jagmevada/show-timer/cad/holder_with clips.jpeg

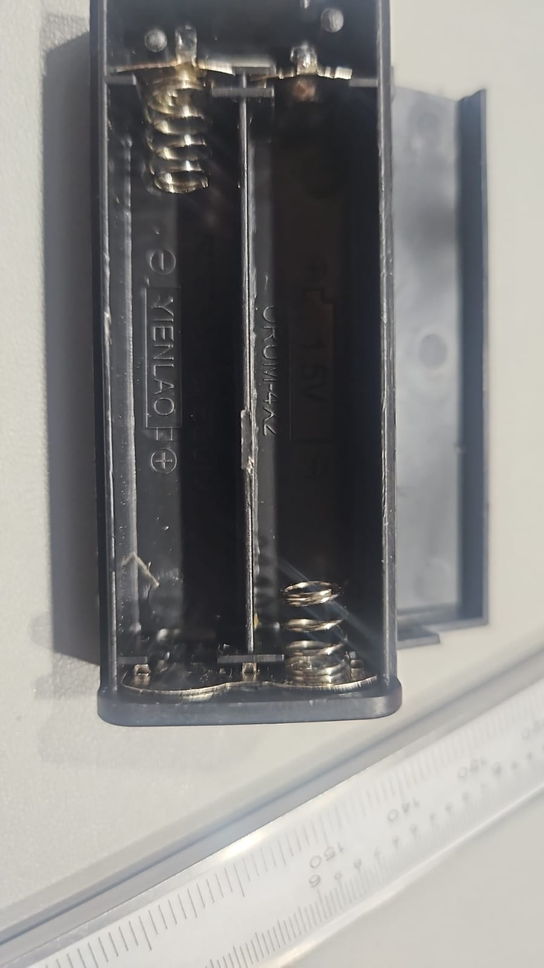
cad/holder_with clips.jpeg
