jagmevada/show-timer/cad/holder_without_clips.jpeg

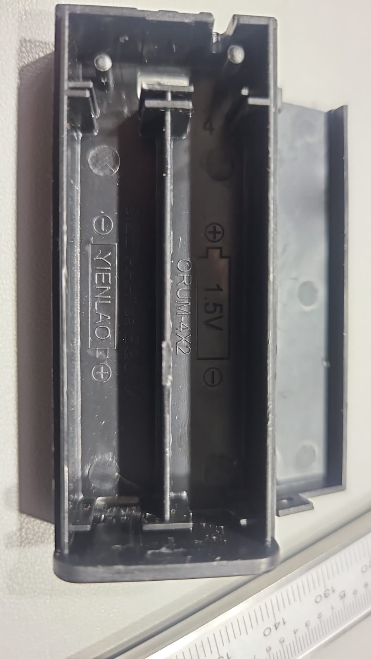
cad/holder_without_clips.jpeg
