jagmevada/show-timer/work/old_board_geom.md

# remote_1 (built board) geometry, read 2026-10-11 from JLCONE PCB 52caa9452ee66dee (mil, layer 1 = top, 2 = bottom)
Outline: x 1.2…1418.5, y −59.4…2952.4 (36.0 × 76.5 mm). Corners: large concave/convex arc steps (see polys below).
Polylines (layer 11):
L 119.29,2686.61→79.92,2686.61 | L 266.93,2873.62→266.93,2834.25 | L 1152.76,2834.25→1152.76,2873.62 | L 1339.76,2686.61→1300.39,2686.61
L 1300.39,206.30→1339.76,206.30 | L 1152.76,19.29→1152.76,58.66 | L 266.93,58.66→266.93,19.29 | L 79.92,206.30→119.29,206.30
L 1418.50,285.04→1418.50,2607.87 | L 345.67,−59.45→1074.02,−59.45 | L 1.18,2607.87→1.18,285.04 | L 1074.02,2952.36→345.67,2952.36
ARC90 79.92,2686.61→1.18,2607.87 | ARC90 119.29,2686.61→266.93,2834.25 | ARC90 345.67,2952.36→266.93,2873.62 | ARC90 1152.76,2873.62→1074.02,2952.36
ARC90 1152.76,2834.25→1300.39,2686.61 | ARC90 1418.50,2607.87→1339.76,2686.61 | ARC90 1339.76,206.30→1418.50,285.04 | ARC90 1300.39,206.30→1152.76,58.66
ARC90 1074.02,−59.45→1152.76,19.29 | ARC90 266.93,19.29→345.67,−59.45 | ARC90 266.93,58.66→119.29,206.30 | ARC90 1.18,285.04→79.92,206.30

Keep positions (top): S1 power 276.8,1141.3 | S2 709.8,1141.3 | S3 276.8,708.3 | S4 709.8,708.3 | S5 1142.9,708.3 | S6 709.8,275.2 (all rot 0)
  (S1 = power on PA6 net "S6"; nav S2..S6 → nets S1..S5 in old schematic)
JP1 OLED header top 709.8,2576.4 rot 180 | JP4 batt top 1279.5,2405.5 rot 90 | JP2 batt bottom 141.7,2405.5 rot 90
JP3 UPDI top 1333.4,1427.7 rot −90 | JP5 UART bottom 1330.1,1804.5 rot 90 | A1 HC-12 bottom 709.8,983.9 rot 0
JP6/JP7 (VBAT→VBAT_O jumpers) bottom 142.5,2163.4 / 1278,2163.4
U1 MCU bottom 913.8,1558.2 rot 270 | U2 DC-DC bottom 309.4,1684.6 | L1 bottom 304.7,1459.1
