jagmevada/show-timer/cad/clips.jpeg

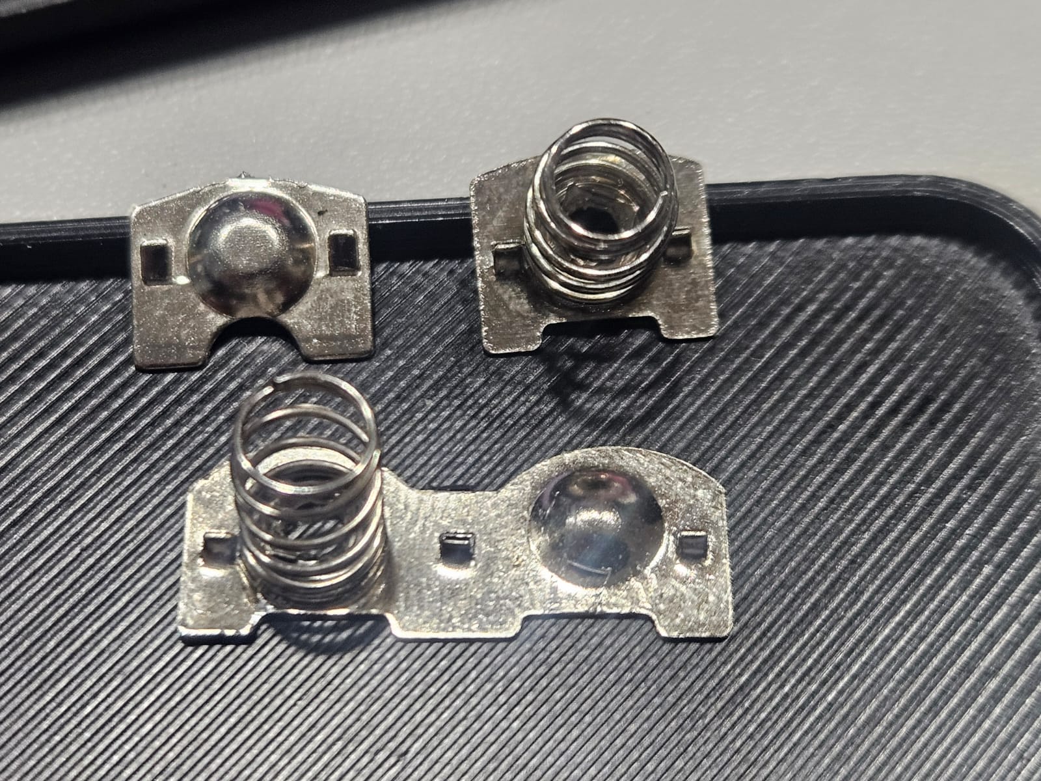
cad/clips.jpeg
