jagmevada/show-timer/cad/plate_zoome.jpeg

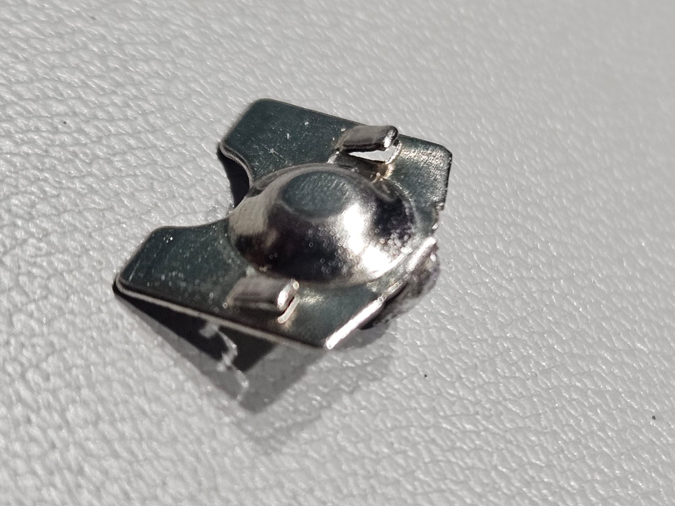
cad/plate_zoome.jpeg
