jagmevada/show-timer/cad/series_clip_zoom_image.jpeg

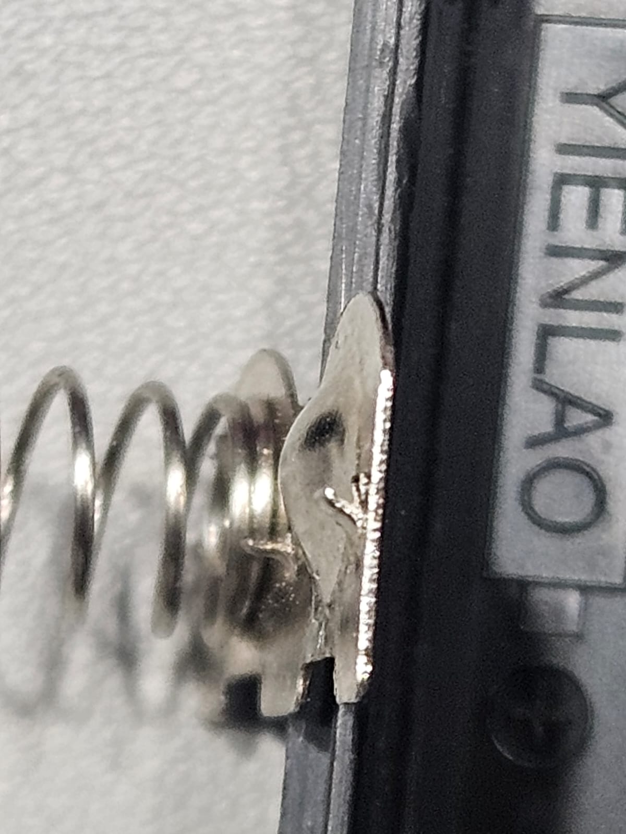
cad/series_clip_zoom_image.jpeg
