jagmevada/show-timer/cad/spring_zoom.jpeg

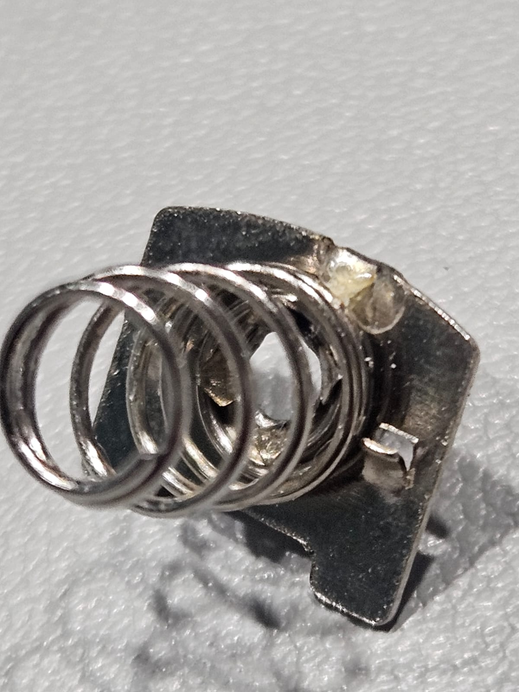
cad/spring_zoom.jpeg
