jagmevada/show-timer/docs/datasheets/TS-1187A_drawing.jpg

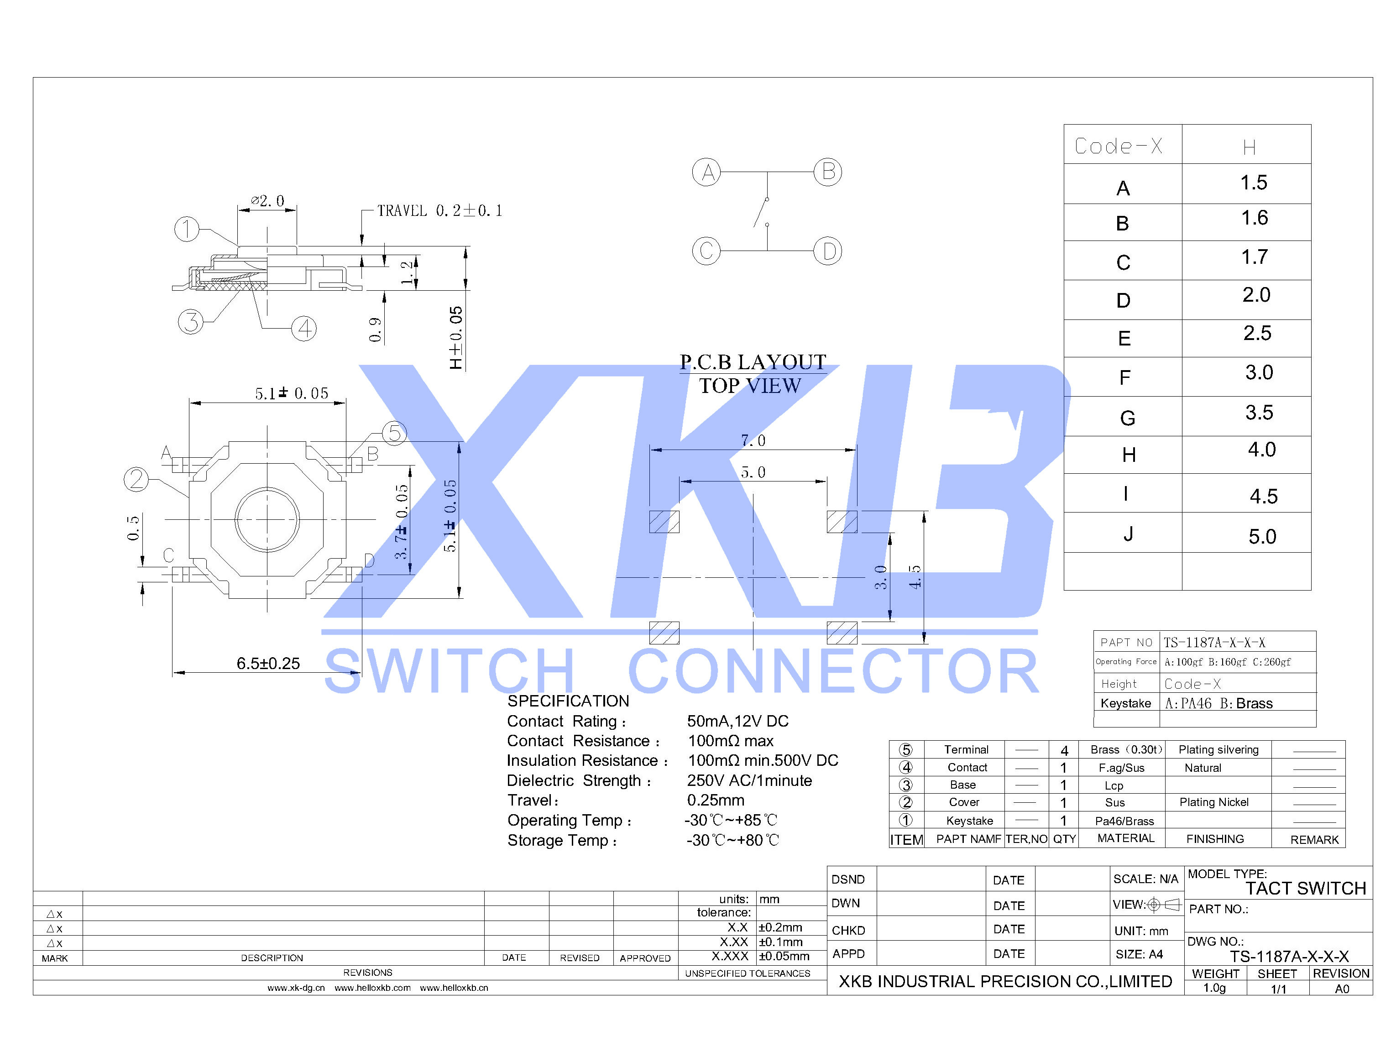
docs/datasheets/TS-1187A_drawing.jpg
