jagmevada/show-timer/docs/images/silk_bottom_gerber_topview.png

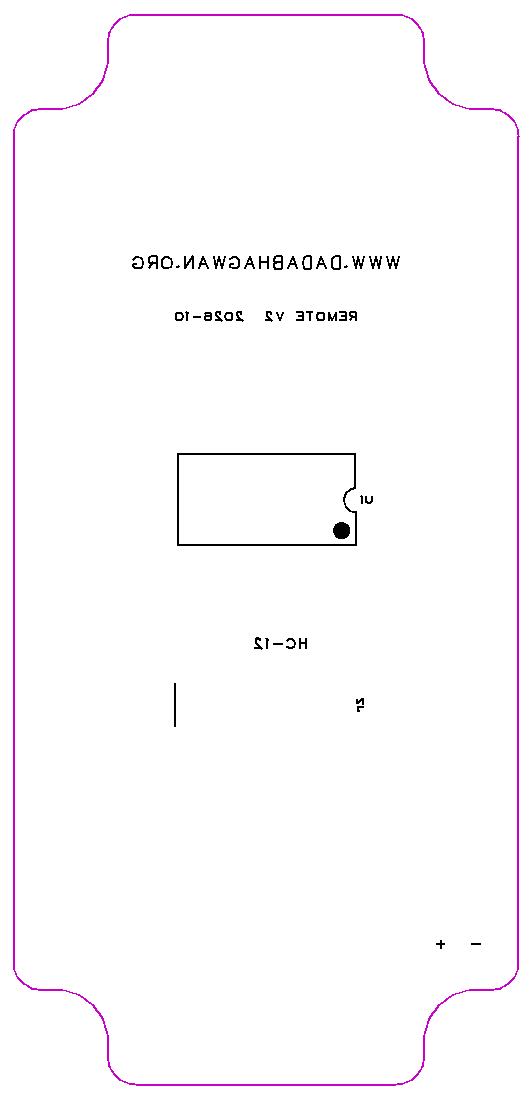
docs/images/silk_bottom_gerber_topview.png
