jagmevada/show-timer/docs/images/silk_top_gerber.png

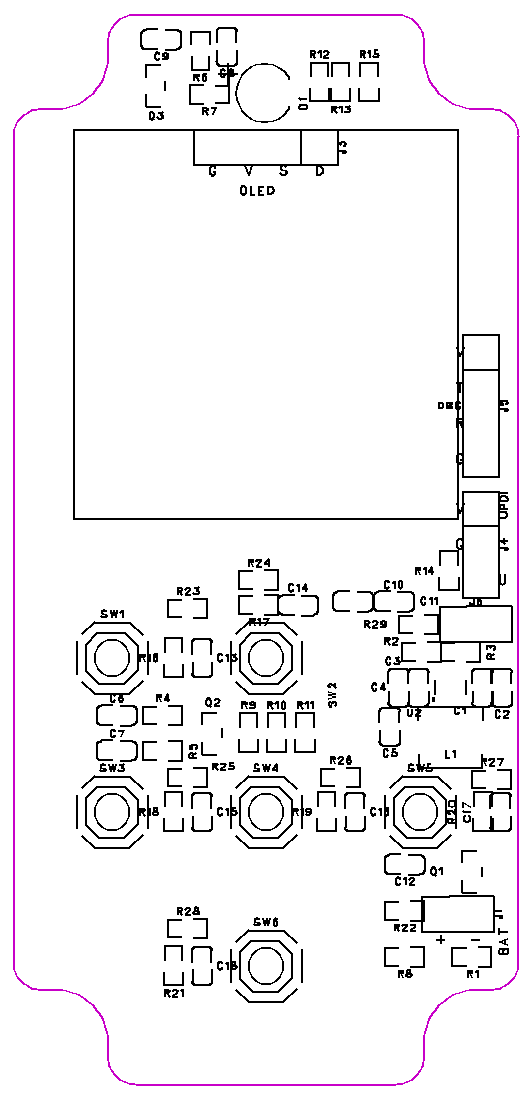
docs/images/silk_top_gerber.png
