jagmevada/show-timer/release/remote_v2_2026-10-11_BOM.csv

Supplier | Supplier Part | Manufacturer | Manufacturer Part | Value | Footprint | Designator | Comment | Quantity | No.
LCSC | C19702 | SAMSUNG(三星) | CL10A106KP8NNNC | 10uF | C0603 | C1,C9 | 10uF | 2 | 1
LCSC | C14663 | YAGEO(国巨) | CC0603KRX7R9BB104 | 100nF | C0603 | C2,C5,C10,C12,C13,C14,C15,C16,C17,C18 | 100nF | 10 | 2
LCSC | C59461 | SAMSUNG(三星) | CL10A226MQ8NRNC | 22uF | C0603 | C3,C4,C7,C11 | 22uF | 4 | 3
LCSC | C1622 | SAMSUNG(三星) | CL10B473KB8NNNC | 47nF | C0603 | C6,C8 | 47nF | 2 | 4
LCSC | C167203 | cjiang(长江微电) | FXL0420-1R0-M | 1uH | IND-SMD_L4.4-W4.2 | L1 | 1uH | 1 | 5
LCSC | C15127 | AOS | AO3401A |  | SOT-23_L2.9-W1.3-P1.90-LS2.4-BR | Q1,Q2,Q3 | AO3401A | 3 | 6
LCSC | C25803 | UNI-ROYAL(厚声) | 0603WAF1003T5E | 100kΩ | R0603 | R1,R4,R6 | 100kΩ | 3 | 7
LCSC | C23178 | UNI-ROYAL(厚声) | 0603WAF4703T5E | 470kΩ | R0603 | R2 | 470kΩ | 1 | 8
LCSC | C23254 | UNI-ROYAL(厚声) | 0603WAF8202T5E | 82kΩ | R0603 | R3 | 82kΩ | 1 | 9
LCSC | C25804 | UNI-ROYAL(厚声) | 0603WAF1002T5E | 10kΩ | R0603 | R5,R7,R23,R24,R25,R26,R27,R28 | 10kΩ | 8 | 10
LCSC | C23137 | UNI-ROYAL(厚声) | 0603WAF3303T5E | 330kΩ | R0603 | R8 | 330kΩ | 1 | 11
LCSC | C21190 | UNI-ROYAL(厚声) | 0603WAF1001T5E | 1kΩ | R0603 | R9,R10,R11,R15,R16,R17,R18,R19,R20,R21 | 1kΩ | 10 | 12
LCSC | C23162 | UNI-ROYAL(厚声) | 0603WAF4701T5E | 4.7kΩ | R0603 | R12,R13 | 4.7kΩ | 2 | 13
LCSC | C23179 | UNI-ROYAL(厚声) | 0603WAF4700T5E | 470Ω | R0603 | R14 | 470Ω | 1 | 14
LCSC | C22935 | UNI-ROYAL(厚声) | 0603WAF1004T5E | 1MΩ | R0603 | R22 | 1MΩ | 1 | 15
LCSC | C23192 | UNI-ROYAL(厚声) | 0603WAF5103T5E | 510kΩ | R0603 | R29 | 510kΩ | 1 | 16
LCSC | C318884 | XKB Connection(中国星坤) | TS-1187A-B-A-B |  | SW-SMD_4P-L5.1-W5.1-P3.70-LS6.5-TL_H1.5 | SW1,SW2,SW3,SW4,SW5,SW6 | TS-1187A-B-A-B | 6 | 17
LCSC | C5219190 | TI(德州仪器) | TPS631000DRLR |  | SOT-583-8_L2.1-W1.2-P0.50-LS1.6-BL | U2 | TPS631000DRLR | 1 | 18
