jagmevada/show-timer/cad/Top Cover Flex Buttons.STEP

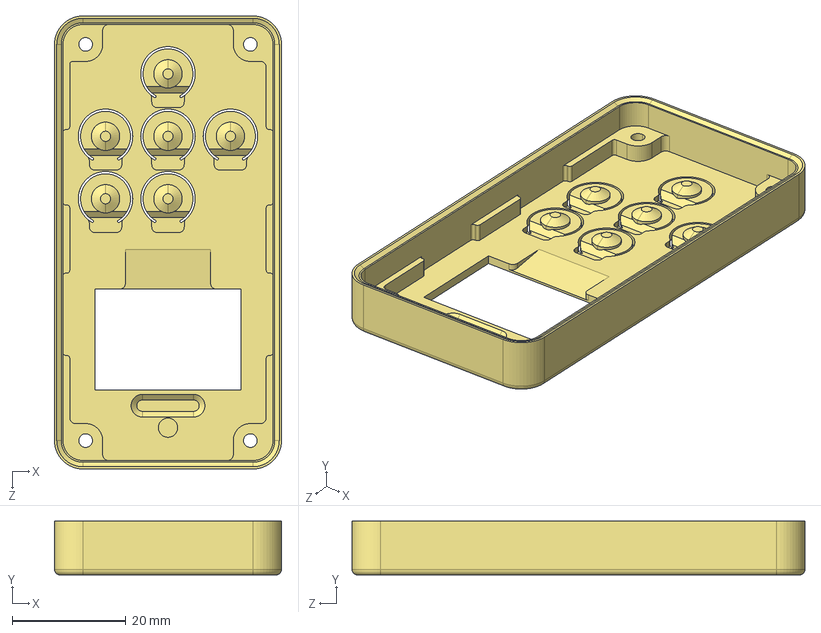
[picture p11: CAD file, 2026-11-08]
cad/Top Cover Flex Buttons.STEP
40.0 x 9.50 x 79.8 mm
