jagmevada/show-timer/cad/Battery Door 2xAAA.stp

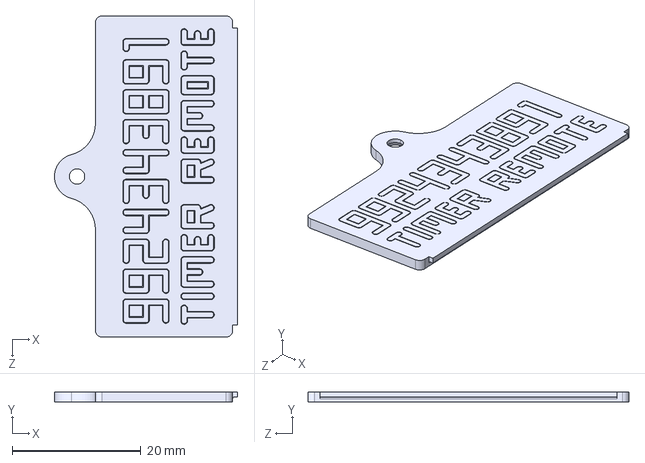
[picture p12: CAD file, 2026-11-08]
cad/Battery Door 2xAAA.stp
28.4 x 1.60 x 49.8 mm
