jagmevada/show-timer/cad/Bottom Cover 2xAAA Split.stp

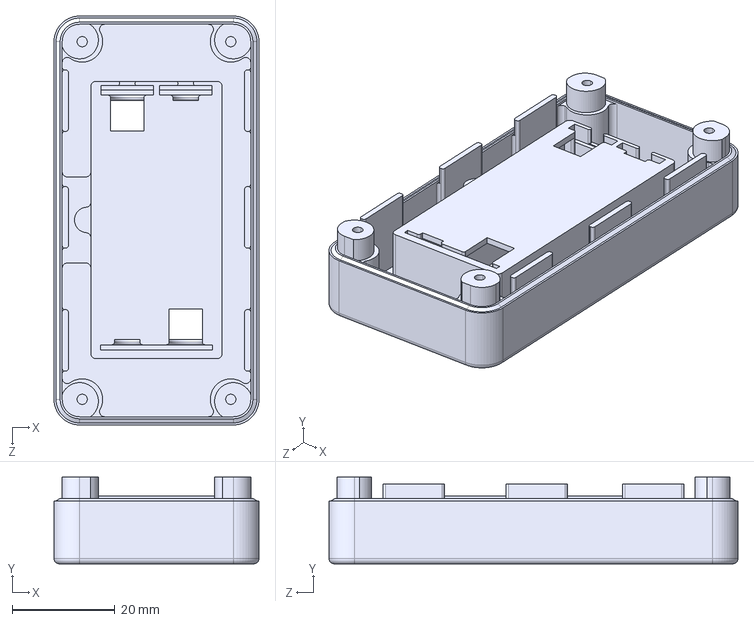
[picture p13: CAD file, 2026-11-08]
cad/Bottom Cover 2xAAA Split.stp
40.0 x 16.9 x 79.8 mm
