jagmevada/show-timer/cad/Clip Plus 10 (dimple).SLDPRT

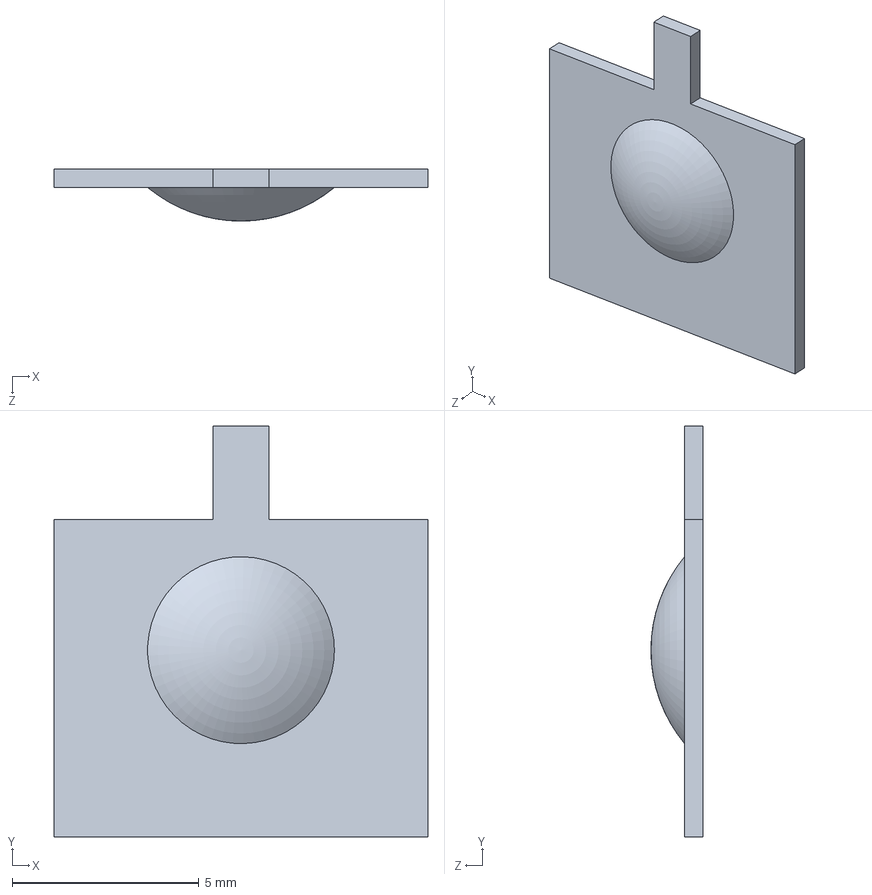
[picture p14: CAD file, 2026-11-07]
cad/Clip Plus 10 (dimple).SLDPRT
10.0 x 11.0 x 1.40 mm
