jagmevada/show-timer/cad/Clip Minus 10 (spring).SLDPRT

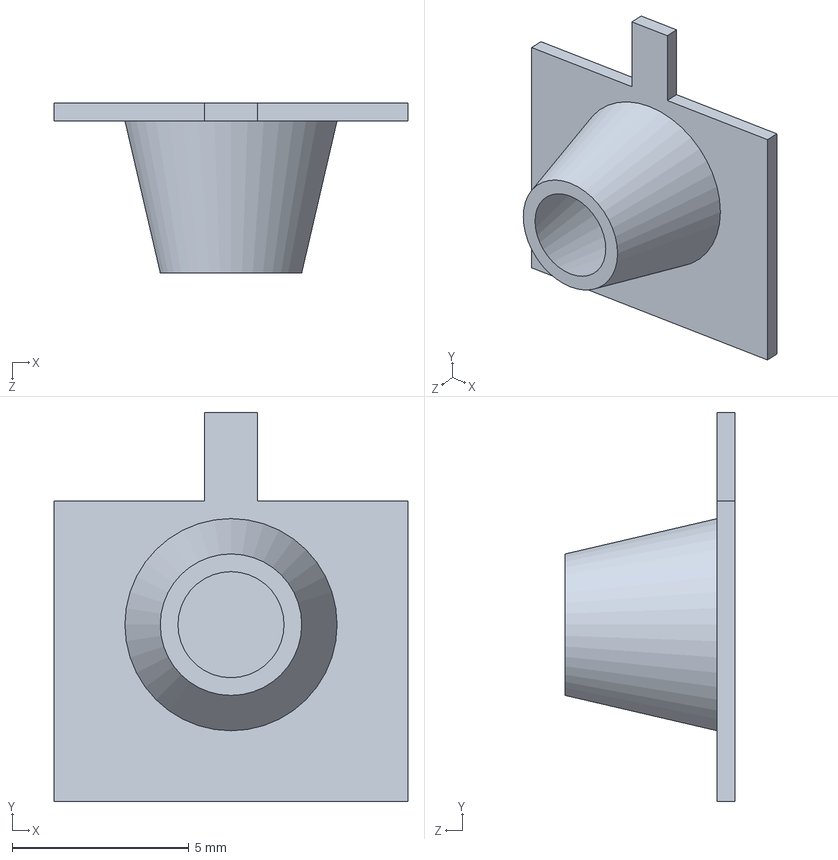
[picture p15: CAD file, 2026-11-07]
cad/Clip Minus 10 (spring).SLDPRT
10.0 x 11.0 x 4.80 mm
