jagmevada/show-timer/cad/Clip Series 21.6 (spring + dimple).SLDPRT

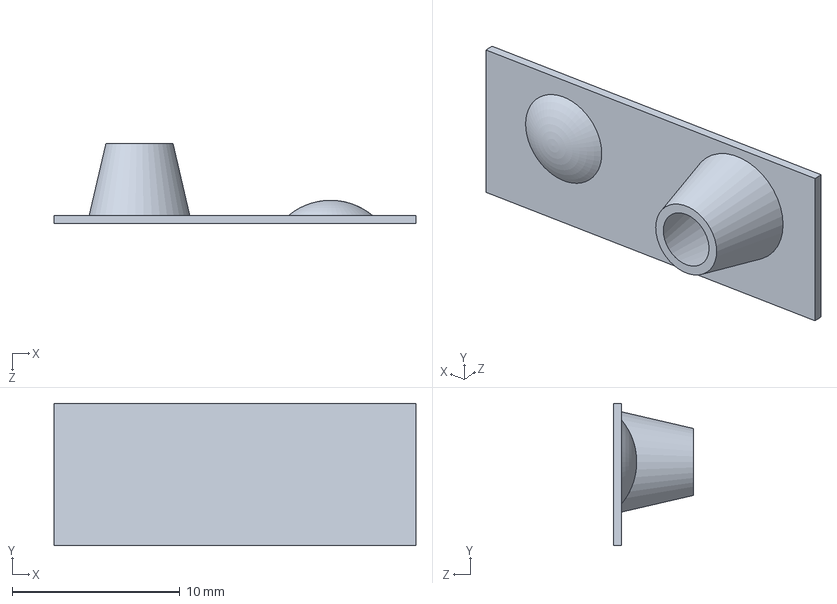
[picture p16: CAD file, 2026-11-07]
cad/Clip Series 21.6 (spring + dimple).SLDPRT
21.6 x 8.50 x 4.80 mm
