jagmevada/show-timer/cad/Bottom Cover 2xAAA.stp

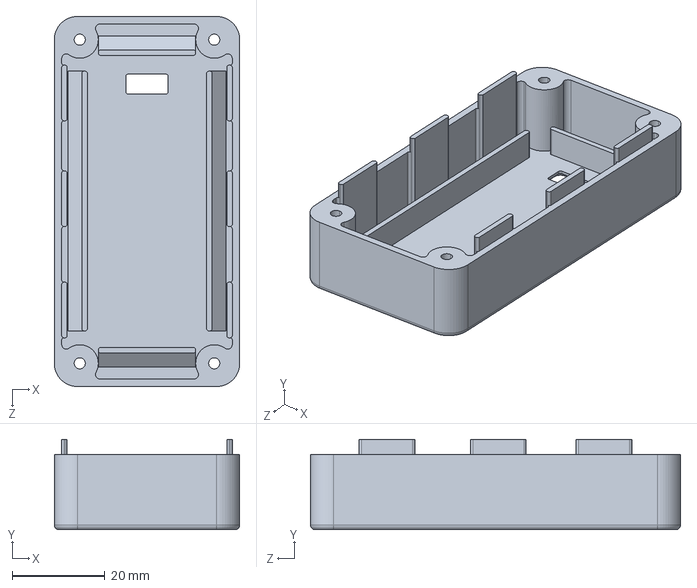
[picture p17: CAD file, 2026-11-07]
cad/Bottom Cover 2xAAA.stp
40.0 x 19.5 x 79.8 mm
