jagmevada/show-timer/cad/2xAAA Holder.SLDPRT

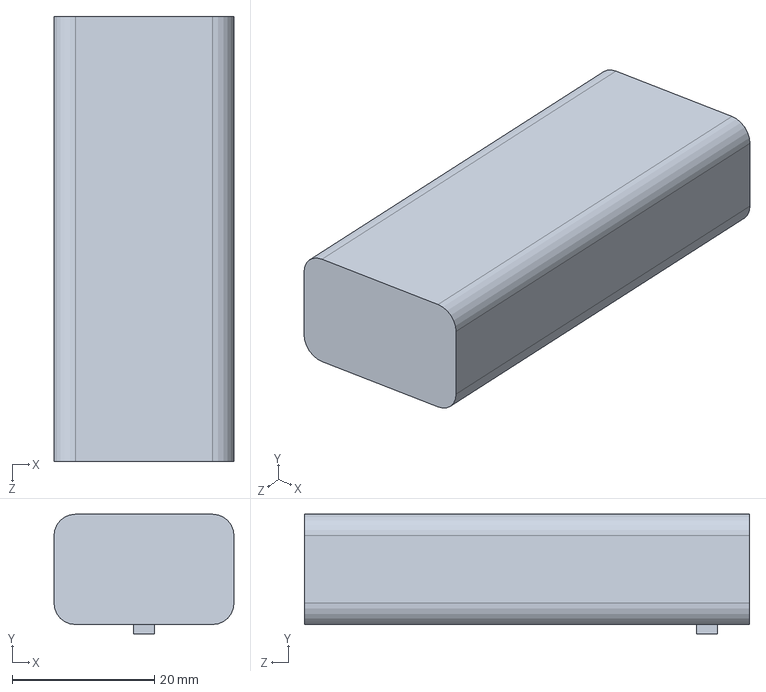
[picture p18: CAD file, 2026-11-07]
cad/2xAAA Holder.SLDPRT
25.3 x 16.8 x 62.6 mm
