jagmevada/show-timer/cad/remote_v2_easyeda.step

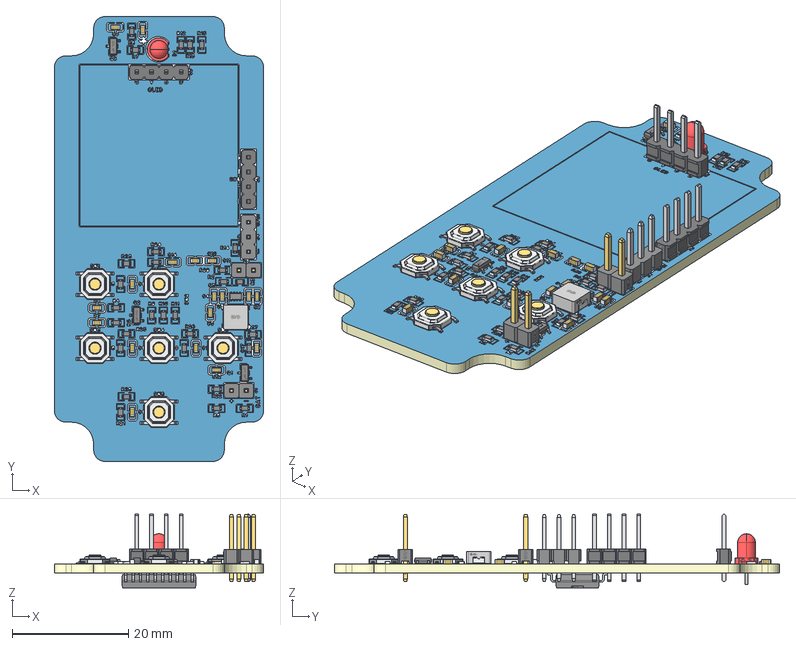
[picture p19: CAD file, 2026-11-07]
cad/remote_v2_easyeda.step
36.0 x 76.5 x 12.6 mm
Board~RLxt
TopCopper~RLxt
BottomCopper~RLxt
TopSilkscreen~RLxt x 264
BottomSilkscreen~RLxt x 47
TopFpcStiffener~RLxt
BottomFpcStiffener~RLxt
C0603~C0603_L1.6-W0.8-H0.8~PFH3 x 18
SOT-23_L2.9-W1.3-P1.90-LS2.4-BR~SOT-23-3P_L2.9-W1.3-H1.0-LS2.4-P0.95~D9QO x 3
HDR-TH_4P-P2.54-V-M~HDR-TH_4P-P2.54-M-LI-1X4P~CmQn x 2
R0603~R0603~sLe5 x 29
IND-SMD_L4.4-W4.2~IND-SMD_L4.2-W4.4-H2.0~V463
HDR-TH_3P-P2.54-V-M_PZ254V-11-03P~HDR-TH_3P-P2.54-V-M_PZ254V-11-03P~YAWt
HDR-TH_2P-P2.54-V-M~HDR2.54-M-LI-1X2P~ll9v x 2
SOT-583-8_L2.1-W1.2-P0.50-LS1.6-BL~SOT-583-8_L2.1-W1.2-P0.50-LS1.6-BL~nwCS
SW-SMD_4P-L5.1-W5.1-P3.70-LS6.5-TL_H1.5~SW-SMD_4P-L5.1-W5.1-P3.70-LS6.5-TL_H1.5~J6qV x 6
SOIC-20_L12.8-W7.5-P1.27-LS10.3-BL~SOIC-20_L12.8-W7.5-P1.27-LS10.3-BL~DwzO
LED-TH_BD3.8-P2.54-FD~LED-TH_BD3.8-P2.54-FD~qmMz
