jagmevada/show-timer/cad/HC-12_module.step

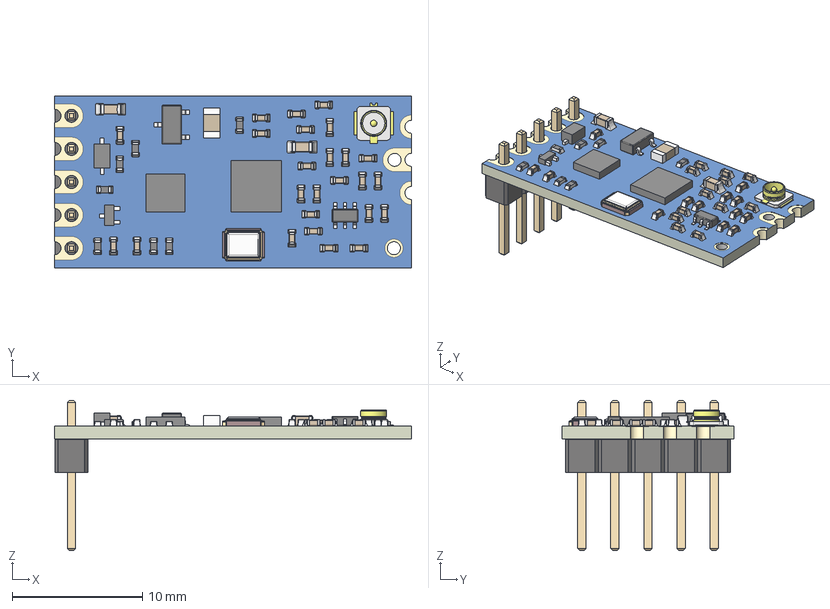
[picture p20: CAD file, 2026-11-07]
cad/HC-12_module.step
27.4 x 13.2 x 11.5 mm
SOP-3
TSOP-6 2mm
resistor_0402 x 7
cap0603_03 x 2
cap0402 x 25
HC12-PCB
PinHeader_1x05_P254mm_Vertical
