jagmevada/show-timer/cad/Remote Assembly v3.SLDASM

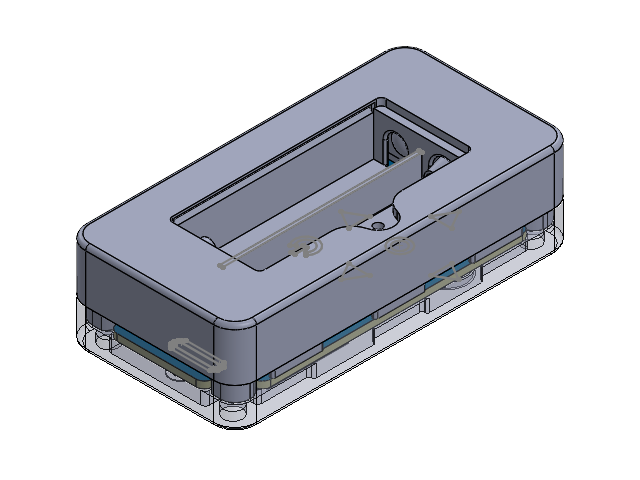
[picture p21: CAD file, 2026-11-09]
cad/Remote Assembly v3.SLDASM
Top Cover Flex Buttons
remote_v2_assembly
Bottom Cover 2xAAA Split
Clip Series 21.6 (spring + dimple)
Clip Plus 10 (dimple)
Clip Minus 10 (spring)
