jagmevada/show-timer/cad/Remote Assembly v2.SLDASM

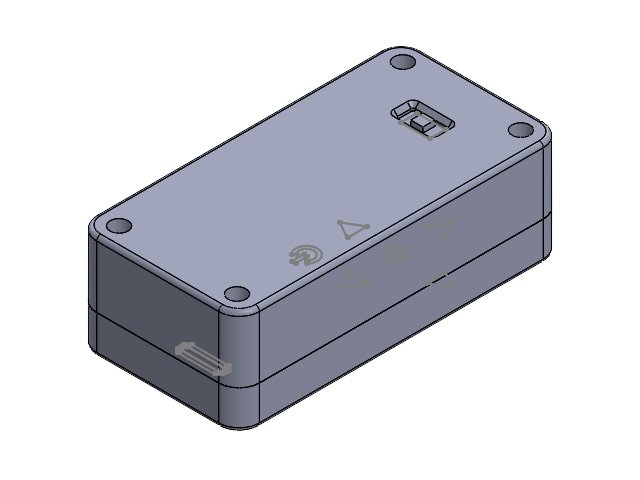
[picture p22: CAD file, 2026-11-09, an earlier design]
cad/Remote Assembly v2.SLDASM
Top Cover Flex Buttons
remote_v2_assembly
Bottom Cover 2xAAA
2xAAA Holder
