jagmevada/show-timer/(list of files, cad)

Other CAD files:
cad/Battery Door 2xAAA.SLDPRT
cad/Bottom Cover 2xAAA Split.SLDPRT
cad/Bottom Cover 2xAAA.SLDPRT
cad/Top Cover Flex Buttons.SLDPRT
cad/Top Cover Flex Buttons.stp
cad/remote_v2_assembly.SLDASM
cad/remote_v2_assembly.SLDPRT
