jagmevada/show-timer/docs/old_remote/src/github_dcdc/combined.brd

## EAGLE design docs/old_remote/src/github_dcdc/combined.brd (2026-11-02, an earlier design)

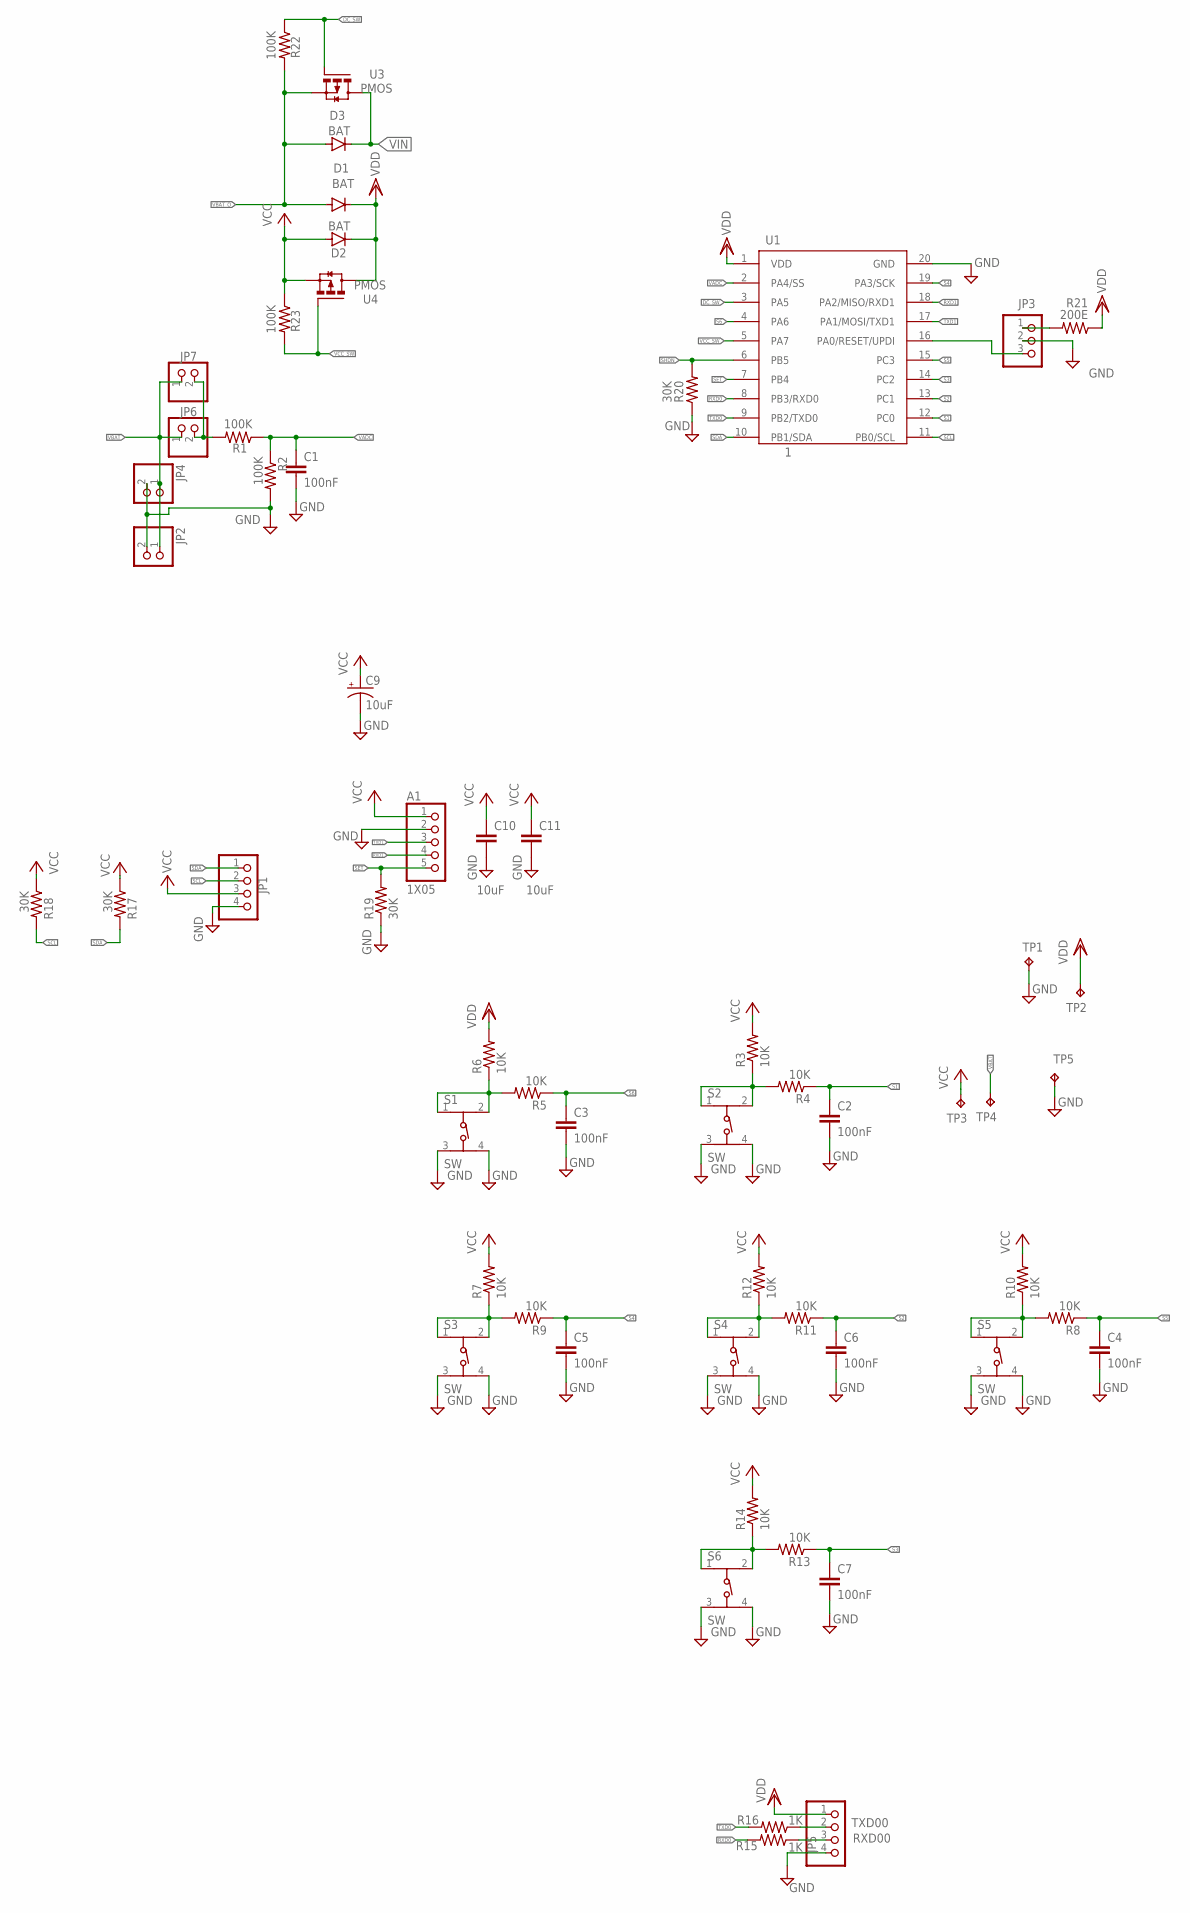
[picture p23: schematic combined.sch, sheet 1]

Parts:
A1: 1X05; 1X05X254
C1, C2, C3, C4, C5, C6, C7: 100nF; C0805
C9: 10uF; CT3528
C10, C11: 10uF; C0805
D1, D2, D3: BAT; SOD-123_MINI-SMA
JP1, JP5: PINHD-1X04_2.54-S; 1X04-S
JP2, JP4, JP6, JP7: PINHD-1X02_2.54-S; 1X02-S
JP3: PINHD-1X03_2.54-S; 1X03-S
R1, R2, R22, R23: 100K; R0805
R3, R4, R5, R6, R7, R8, R9, R10, R11, R12, R13, R14: 10K; R0805
R15, R16: 1K; R0805
R17, R18, R19, R20: 30K; R0805
R21: 200E; R0805
S1, S2, S3, S4, S5, S6: SW; SW_55MM
TP1, TP5: GND; TP18R
TP2: VDD; TP18R
TP3: VCC; TP18R
TP4: VBAT; TP18R
U1: 1; SOIC127P1032X265-20N
U3, U4: PMOS; SOT103P240X110-3N

Connections:
DC_SW: R22.1, U1.3 (PA5), U3.1 (G)
GND: A1.2, C1.2, C2.2, C3.2, C4.2, C5.2, C6.2, C7.2, C9.-, C10.2, C11.2, JP1.4, JP2.2, JP3.2, JP4.2, JP5.4, R2.2, R19.1, R20.1, S1.3, S1.4, S2.3, S2.4, S3.3, S3.4, S4.3, S4.4, S5.3, S5.4, S6.3, S6.4, TP1.TP, TP5.TP, U1.20 (GND); also elsewhere on the board
unnamed: R5.2, R6.1, S1.1, S1.2
unnamed: JP3.3, U1.16 (PA0/RESET/UPDI)
unnamed: JP3.1, R21.2
unnamed: R11.2, R12.1, S4.1, S4.2
unnamed: R13.2, R14.1, S6.1, S6.2
unnamed: R7.1, R9.2, S3.1, S3.2
unnamed: R8.2, R10.1, S5.1, S5.2
unnamed: R3.1, R4.2, S2.1, S2.2
RXD0: R15.2, U1.8 (PB3/RXD0)
RXD00: JP5.3, R15.1
RXD1: A1.4, U1.18 (PA2/MISO/RXD1)
S1: C2.1, R4.1, U1.12 (PC0)
S2: C6.1, R11.1, U1.13 (PC1)
S3: C7.1, R13.1, U1.14 (PC2)
S4: C5.1, R9.1, U1.19 (PA3/SCK)
S5: C4.1, R8.1, U1.15 (PC3)
S6: C3.1, R5.1, U1.4 (PA6)
SCL: JP1.2, R18.2, U1.11 (PB0/SCL)
SDA: JP1.1, R17.2, U1.10 (PB1/SDA)
SET: A1.5, R19.2, U1.7 (PB4)
SHDN: R20.2, U1.6 (PB5); also elsewhere on the board
TXD0: R16.2, U1.9 (PB2/TXD0)
TXD00: JP5.2, R16.1
TXD1: A1.3, U1.17 (PA1/MOSI/TXD1)
VADC: C1.1, R1.1, R2.1, U1.2 (PA4/SS)
VBAT: JP2.1, JP4.1, JP6.1, JP7.1, TP4.TP
VBAT_O: D1.A, D3.A, JP6.2, JP7.2, R1.2, R22.2, U3.2 (S)
VCC: A1.1, C9.+, C10.1, C11.1, D2.A, JP1.3, R3.2, R7.2, R10.2, R12.2, R14.2, R17.1, R18.1, R23.1, TP3.TP, U4.2 (S); also elsewhere on the board
VCC_SW: R23.2, U1.5 (PA7), U4.1 (G)
VDD: D1.C, D2.C, JP5.1, R6.2, R21.1, TP2.TP, U1.1 (VDD), U4.3 (D)
VIN: D3.C, U3.3 (D); also elsewhere on the board

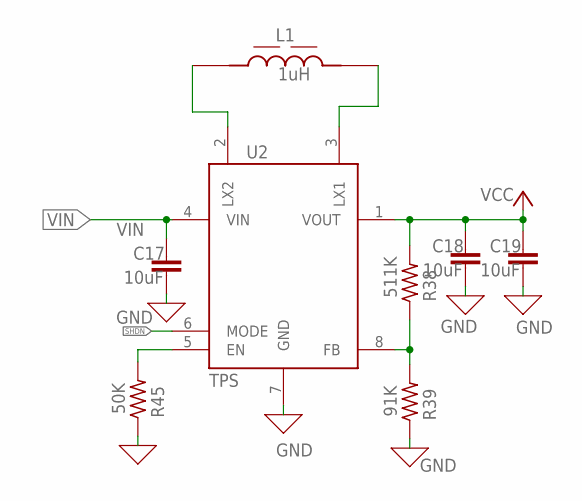
[picture p24: schematic combined.sch, sheet 2, 1]

Parts:
C17, C18, C19: 10uF; C0805
L1: 1uH; IND_74404043220A
R38: 511K; M0805
R39: 91K; M0805
R45: 50K; M0805
U2: TPS; SOTFL50P160X60-8N

Connections:
GND: C17.2, C18.2, C19.2, R39.1, R45.1, U2.7 (GND); also elsewhere on the board
LX1: L1.2, U2.3 (LX1)
LX2: L1.1, U2.2 (LX2)
unnamed: R38.1, R39.2, U2.8 (FB)
unnamed: R45.2, U2.5 (EN)
SHDN: U2.6 (MODE); also elsewhere on the board
VCC: C18.1, C19.1, R38.2, U2.1 (VOUT); also elsewhere on the board
VIN: C17.1, U2.4 (VIN); also elsewhere on the board

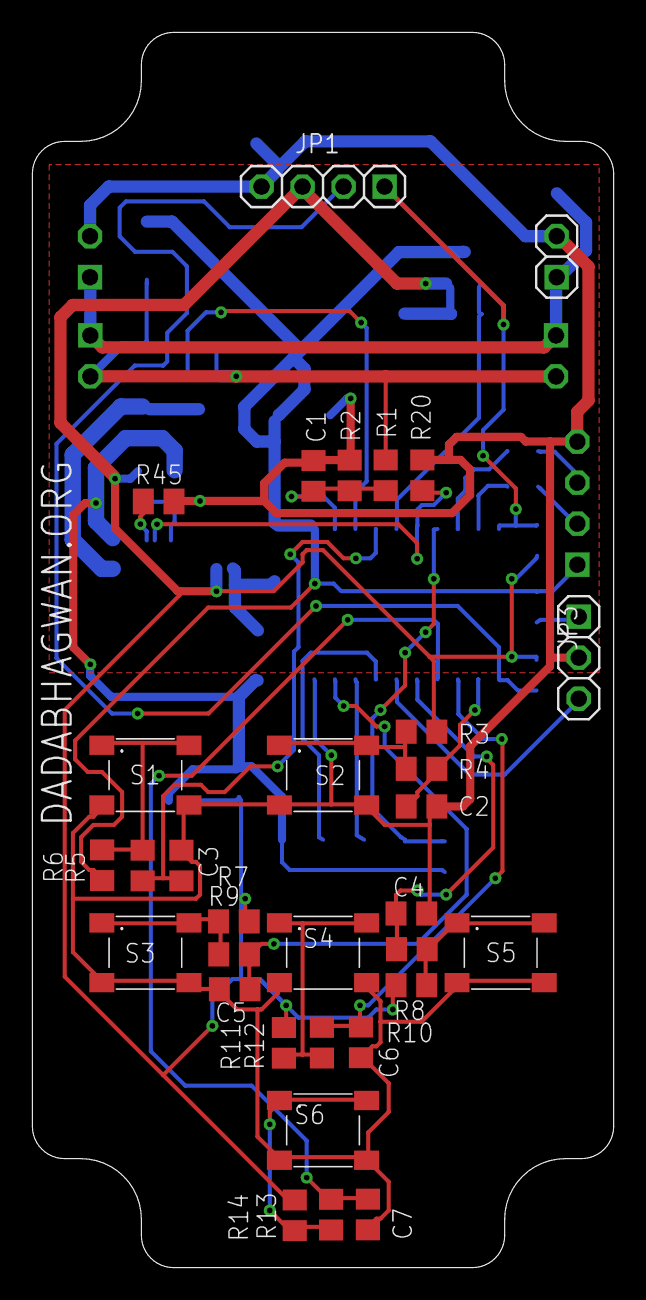
[picture p25: board docs/old_remote/src/github_dcdc/combined.brd from above]

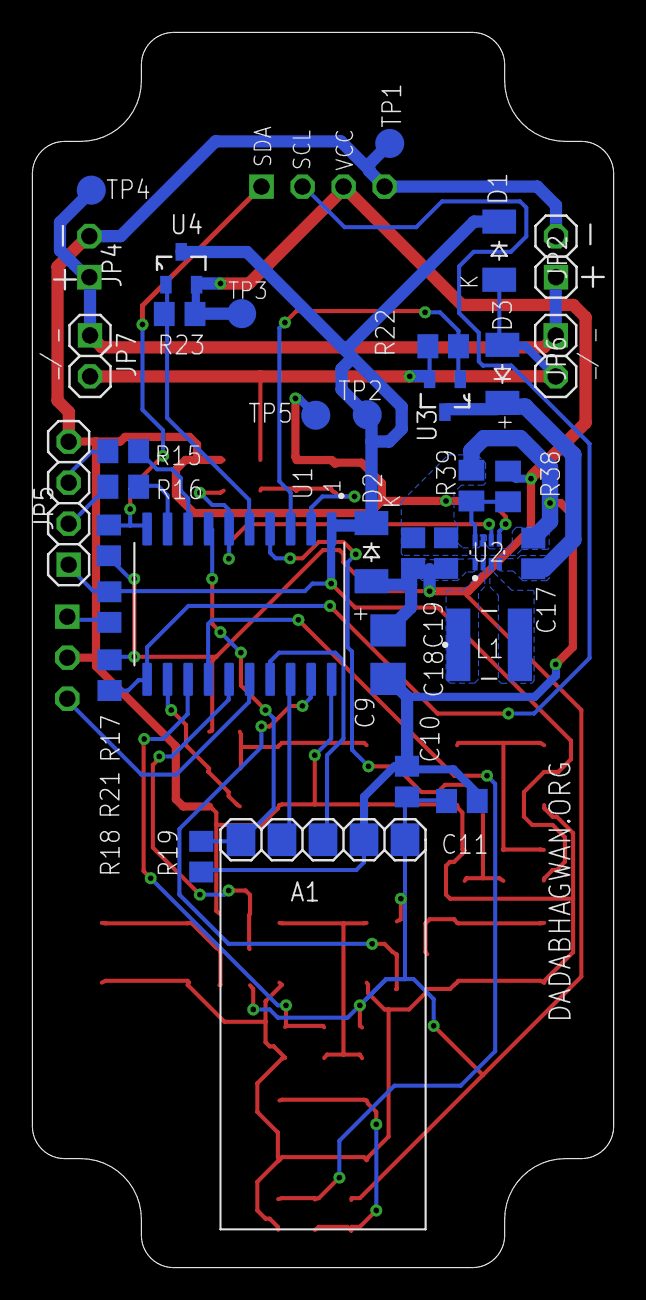
[picture p26: board docs/old_remote/src/github_dcdc/combined.brd from below]

Board: 2 copper layers, 36.0 x 76.5 mm, 66 parts (34 on the bottom side), 37 nets.
