jagmevada/show-timer/docs/old_remote/src/github_panel/combined.brd

## EAGLE design docs/old_remote/src/github_panel/combined.brd (2026-11-02, an earlier design)

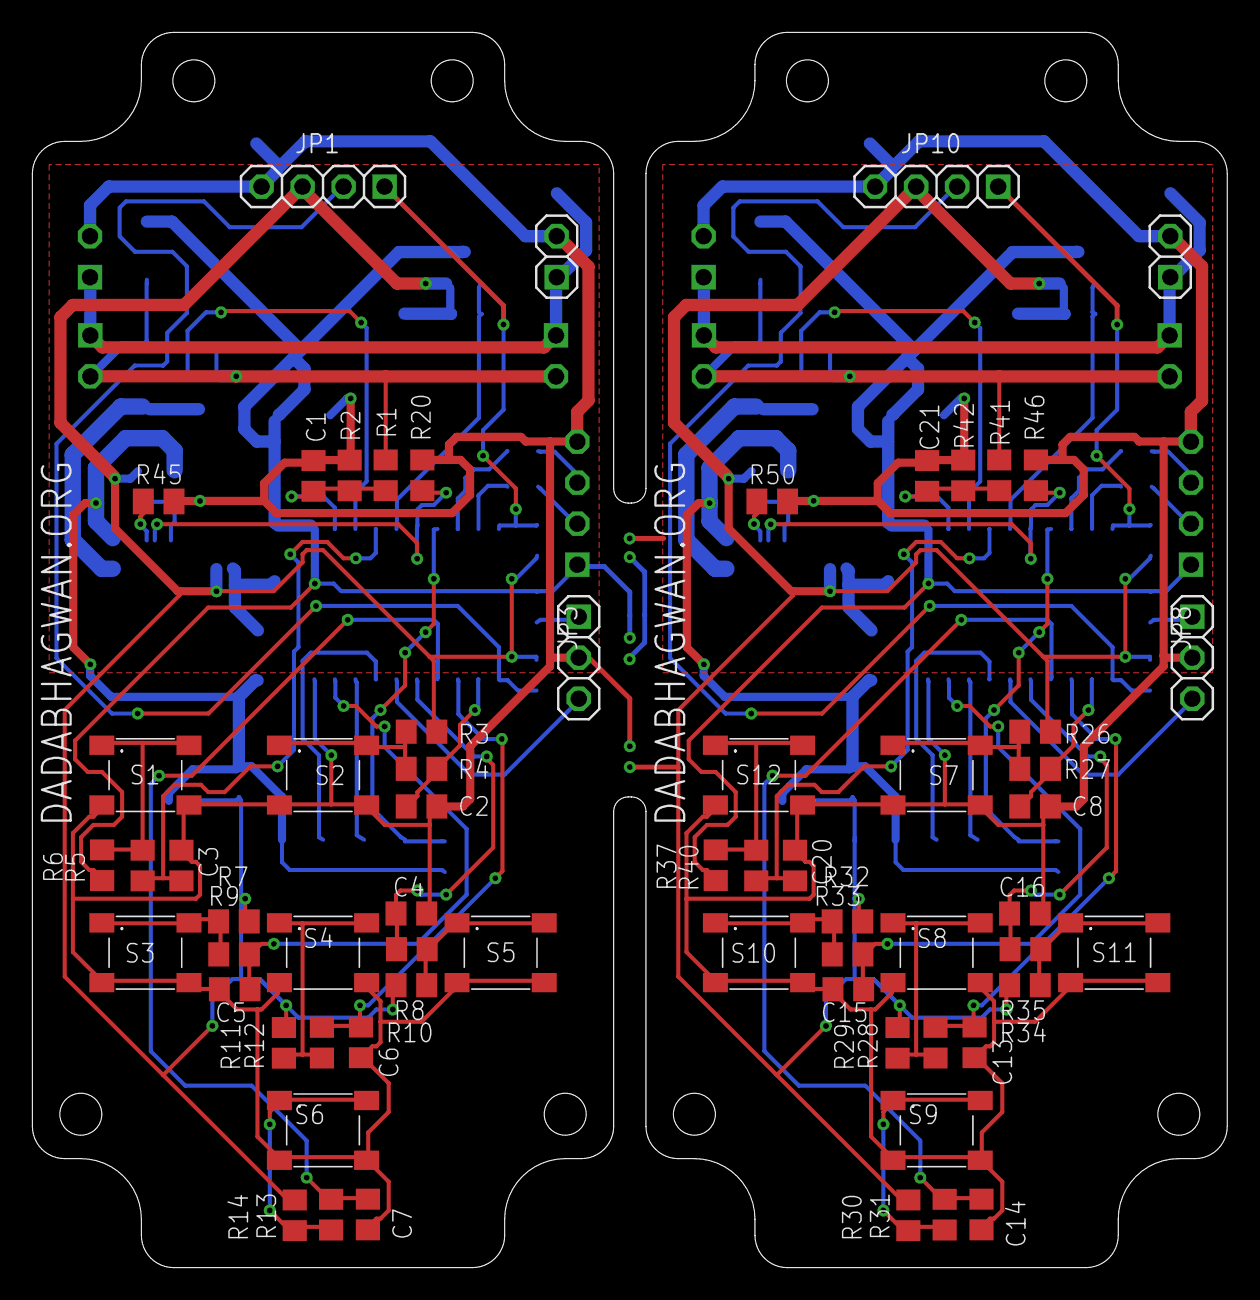
[picture p27: board docs/old_remote/src/github_panel/combined.brd from above]

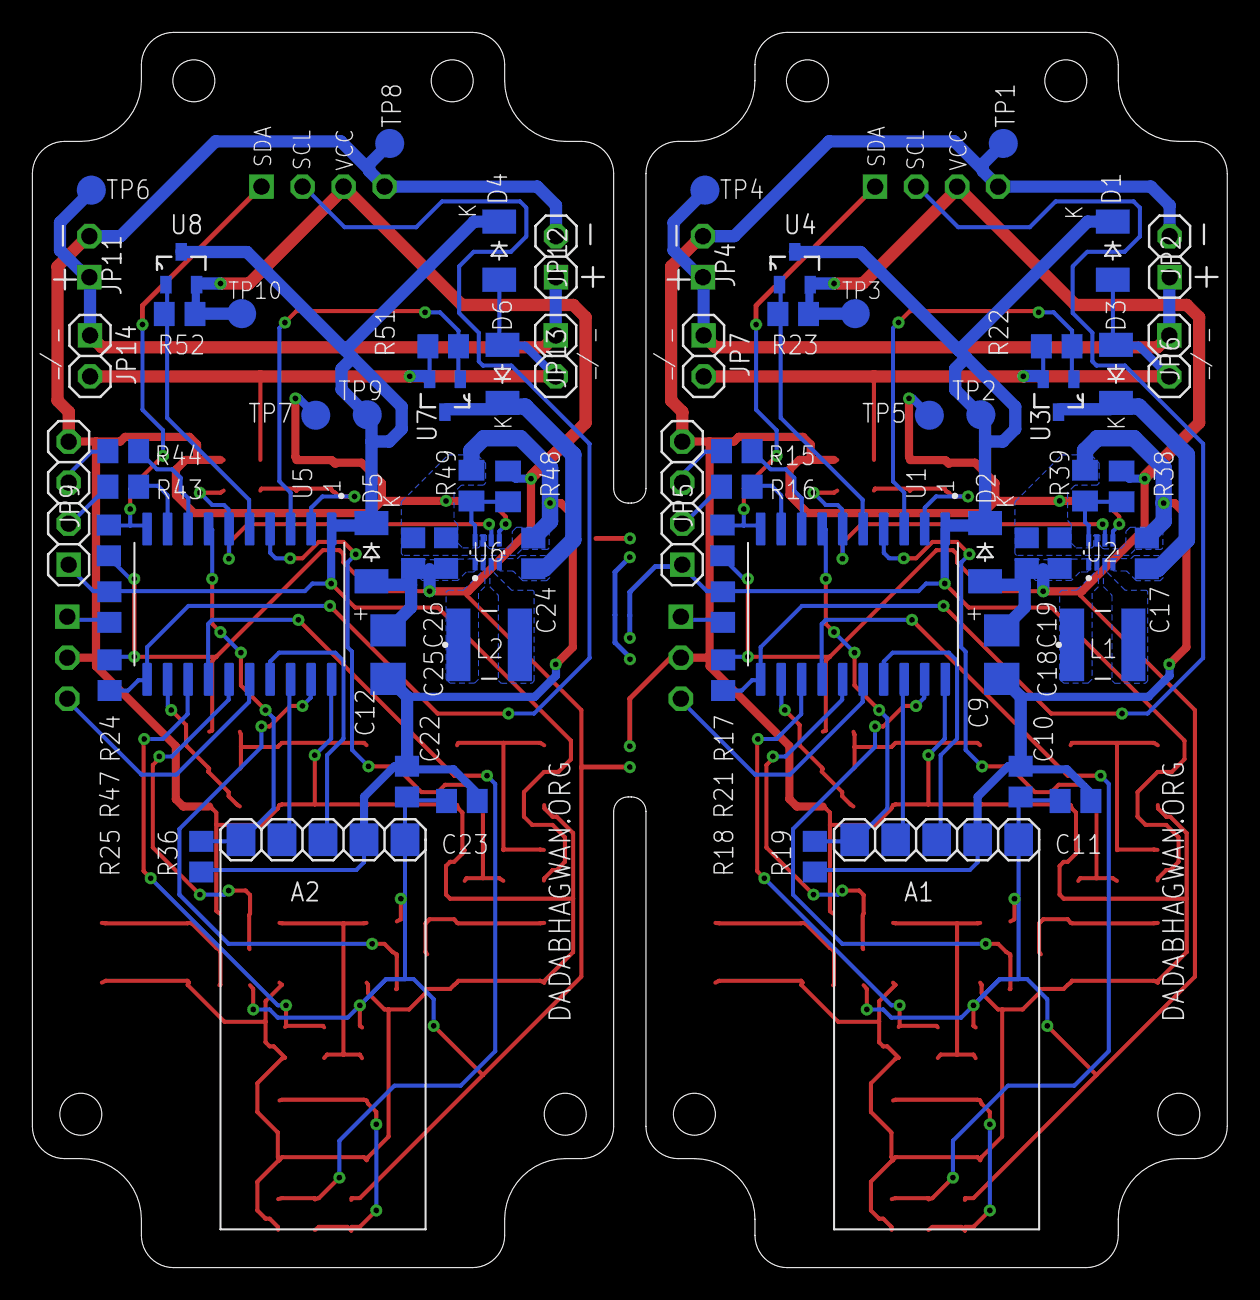
[picture p28: board docs/old_remote/src/github_panel/combined.brd from below]

Board: 2 copper layers, 74.0 x 76.5 mm, 132 parts (68 on the bottom side), 74 nets.

Parts:
A1, A2: 1X05; 1X05X254
C1, C2, C3, C4, C5, C6, C7, C8, C13, C14, C15, C16, C20, C21: 100nF; C0805
C9, C12: 10uF; CT3528
C10, C11, C17, C18, C19, C22, C23, C24, C25, C26: 10uF; C0805
D1, D2, D3, D4, D5, D6: BAT; SOD-123_MINI-SMA
JP1, JP5, JP9, JP10: 1X04-S
JP2, JP4, JP6, JP7, JP11, JP12, JP13, JP14: 1X02-S
JP3, JP8: 1X03-S
L1, L2: 1uH; IND_74404043220A
R1, R2, R22, R23, R41, R42, R51, R52: 100K; R0805
R3, R4, R5, R6, R7, R8, R9, R10, R11, R12, R13, R14, R26, R27, R28, R29, R30, R31, R32, R33, R34, R35, R37, R40: 10K; R0805
R15, R16, R43, R44: 1K; R0805
R17, R18, R19, R20, R24, R25, R36, R46: 30K; R0805
R21, R47: 200E; R0805
R38, R48: 511K; M0805
R39, R49: 91K; M0805
R45, R50: 50K; M0805
S1, S2, S3, S4, S5, S6, S7, S8, S9, S10, S11, S12: SW; SW_55MM
TP1, TP5, TP7, TP8: GND; TP18R
TP2, TP9: VDD; TP18R
TP3, TP10: VCC; TP18R
TP4, TP6: VBAT; TP18R
U1, U5: 1; SOIC127P1032X265-20N
U2, U6: TPS; SOTFL50P160X60-8N
U3, U4, U7, U8: PMOS; SOT103P240X110-3N

Connections:
DC_SW: R22.1, U1.3, U3.1
DC_SW1: R51.1, U5.3, U7.1
GND: A1.2, C1.2, C2.2, C3.2, C4.2, C5.2, C6.2, C7.2, C9.-, C10.2, C11.2, C17.2, C18.2, C19.2, JP1.4, JP2.2, JP3.2, JP4.2, JP5.4, R2.2, R19.1, R20.1, R39.1, R45.1, S1.3, S1.4, S2.3, S2.4, S3.3, S3.4, S4.3, S4.4, S5.3, S5.4, S6.3, S6.4, TP1.TP, TP5.TP, U1.20, U2.7
GND1: A2.2, C8.2, C12.-, C13.2, C14.2, C15.2, C16.2, C20.2, C21.2, C22.2, C23.2, C24.2, C25.2, C26.2, JP8.2, JP9.4, JP10.4, JP11.2, JP12.2, R36.1, R42.2, R46.1, R49.1, R50.1, S7.3, S7.4, S8.3, S8.4, S9.3, S9.4, S10.3, S10.4, S11.3, S11.4, S12.3, S12.4, TP7.TP, TP8.TP, U5.20, U6.7
LX1: L1.2, U2.3
LX2: L1.1, U2.2
LX3: L2.2, U6.3
LX4: L2.1, U6.2
unnamed: R5.2, R6.1, S1.1, S1.2
unnamed: JP3.3, U1.16
unnamed: JP3.1, R21.2
unnamed: R26.1, R27.2, S7.1, S7.2
unnamed: R11.2, R12.1, S4.1, S4.2
unnamed: R28.1, R29.2, S8.1, S8.2
unnamed: R30.1, R31.2, S9.1, S9.2
unnamed: R13.2, R14.1, S6.1, S6.2
unnamed: R7.1, R9.2, S3.1, S3.2
unnamed: R8.2, R10.1, S5.1, S5.2
unnamed: R32.1, R33.2, S10.1, S10.2
unnamed: R3.1, R4.2, S2.1, S2.2
unnamed: R34.1, R35.2, S11.1, S11.2
unnamed: R37.1, R40.2, S12.1, S12.2
unnamed: JP8.3, U5.16
unnamed: JP8.1, R47.2
unnamed: R48.1, R49.2, U6.8
unnamed: R50.2, U6.5
unnamed: R38.1, R39.2, U2.8
unnamed: R45.2, U2.5
RXD0: R15.2, U1.8
RXD00: JP5.3, R15.1
RXD1: A1.4, U1.18
RXD02: R44.2, U5.8
RXD03: A2.4, U5.18
RXD04: JP9.3, R44.1
S1: C2.1, R4.1, U1.12
S2: C6.1, R11.1, U1.13
S3: C7.1, R13.1, U1.14
S4: C5.1, R9.1, U1.19
S5: C4.1, R8.1, U1.15
S6: C3.1, R5.1, U1.4
S7: C8.1, R27.1, U5.12
S8: C13.1, R29.1, U5.13
S9: C14.1, R31.1, U5.14
S10: C15.1, R33.1, U5.19
S11: C16.1, R35.1, U5.15
S12: C20.1, R40.1, U5.4
SCL: JP1.2, R18.2, U1.11
SCL1: JP10.2, R25.2, U5.11
SDA: JP1.1, R17.2, U1.10
SDA1: JP10.1, R24.2, U5.10
SET: A1.5, R19.2, U1.7
SET1: A2.5, R36.2, U5.7
SHDN: R20.2, U1.6, U2.6
SHDN1: R46.2, U5.6, U6.6
TXD0: R16.2, U1.9
TXD00: JP5.2, R16.1
TXD1: A1.3, U1.17
TXD02: R43.2, U5.9
TXD03: A2.3, U5.17
TXD04: JP9.2, R43.1
VADC: C1.1, R1.1, R2.1, U1.2
VADC1: C21.1, R41.1, R42.1, U5.2
VBAT: JP2.1, JP4.1, JP6.1, JP7.1, TP4.TP
VBAT1: JP11.1, JP12.1, JP13.1, JP14.1, TP6.TP
VBAT_O: D1.A, D3.A, JP6.2, JP7.2, R1.2, R22.2, U3.2
VBAT_O1: D4.A, D6.A, JP13.2, JP14.2, R41.2, R51.2, U7.2
VCC: A1.1, C9.+, C10.1, C11.1, C18.1, C19.1, D2.A, JP1.3, R3.2, R7.2, R10.2, R12.2, R14.2, R17.1, R18.1, R23.1, R38.2, TP3.TP, U2.1, U4.2
VCC1: A2.1, C12.+, C22.1, C23.1, C25.1, C26.1, D5.A, JP10.3, R24.1, R25.1, R26.2, R28.2, R30.2, R32.2, R34.2, R48.2, R52.1, TP10.TP, U6.1, U8.2
VCC_SW: R23.2, U1.5, U4.1
VCC_SW1: R52.2, U5.5, U8.1
VDD: D1.C, D2.C, JP5.1, R6.2, R21.1, TP2.TP, U1.1, U4.3
VDD1: D4.C, D5.C, JP9.1, R37.2, R47.1, TP9.TP, U5.1, U8.3
VIN: C17.1, D3.C, U2.4, U3.3
VIN1: C24.1, D6.C, U6.4, U7.3
