jagmevada/show-timer/(commit log)

2026-11-02 remote_v2 PCB design (FINAL 2026-10-11) and bring-up notes
    [combined.brd, combined.sch, dcdc.brd, dcdc.sch, remote_v2_2026-10-11_BOM.csv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]
2026-11-07 Add remote v2 3D CAD for case design; ignore SolidWorks lock files
    - cad/: EasyEDA board export, HC-12 module STEP, full assembly STEP built by
    make_assembly.py, and its SolidWorks part/assembly
    - CLAUDE.md: point to the cad/ assembly
    - .gitignore: skip ~$ SolidWorks temporary lock files
    [HC-12_module.step, remote_v2_assembly.SLDASM, remote_v2_assembly.SLDPRT, remote_v2_assembly.step, remote_v2_easyeda.step]
2026-11-07 Add remote v2 box: top cover, bottom cover and assembly with the PCB
    - Top Cover Flex Buttons: rebuilt top cover with 6 printed C-slot spring
    buttons (Ø8.8 pads, tapered plungers touching the switches), LED window
    with 0.2 mm skin, side guides the PCB rests on
    - Bottom Cover 2xAAA: 15 mm deep closed bottom for a 2xAAA holder, M2 screws
    - Remote Assembly v2: both covers + remote_v2_assembly PCB, width-centred,
    switches under the buttons; box 40 x 79.79 mm
    [Bottom Cover 2xAAA.SLDPRT, Remote Assembly v2.SLDASM, Top Cover Flex Buttons.SLDPRT]
2026-11-07 Remote v2 box: 2xAAA holder, bottom cover around it, button and PCB fit
    - 2xAAA Holder: 25.3 x 62.6 x 15.5 envelope with R3 long edges and its slide
    switch lever; mated in the assembly on U1, centred, guided on 4 sides
    - Bottom cover: 16.2 deep (floor on the holder), slide-switch cutout with a
    finger dish, guide rails with buttresses, tabs 0.1 mm under the PCB, lug and
    vertical-edge fillets for printing; box shortened to 79.79 mm
    - Top cover: C-slot buttons 300 deg / 0.4 slot, user hinge pockets, chamfers
    and fillets on all buttons, tapered plungers touching the switches, PCB on
    the original side guides
    [2xAAA Holder.SLDPRT, Bottom Cover 2xAAA.SLDPRT, Remote Assembly v2.SLDASM, Top Cover Flex Buttons.SLDPRT]
2026-11-07 Remote v2 box: button symbols, I2C header pocket, printable switch slot
    - Top cover: 0.4 mm flush colour inlays on the 6 buttons (PWR, UP, LEFT,
    OK ring, RIGHT, DOWN) as 7 separate bodies for AMS printing; 1.2 mm
    strokes with filleted corners after the first print failed
    - Top cover: 2.0 mm wide I2C header lead pocket over the OLED pins with a
    0.2 mm skin, separate from the LED window (user's Cut-Extrude16 and
    Chamfer3 included)
    - Bottom cover: finger dish removed (needed support face-down); switch slot
    20% bigger (9.12 x 4.32, R0.5) with a 1 x 45 deg support-free chamfer
    - STEP print files for both covers (top: 8 solids)
    [Bottom Cover 2xAAA.SLDPRT, Bottom Cover 2xAAA.stp, Remote Assembly v2.SLDASM, Top Cover Flex Buttons.SLDPRT, Top Cover Flex Buttons.stp]
2026-11-07 Bottom cover: countersink chamfer on all 4 screw holes
    The user's Chamfer2 (1 x 45 deg CSK seat on the counterbore floor edge) had
    lost the hole at x 5.5, d 74.79; added back so all four match. STEP updated.
    [Bottom Cover 2xAAA.SLDPRT, Bottom Cover 2xAAA.stp]
2026-11-07 Remote v3: split bottom cover with built-in 2xAAA compartment + battery door
    - Bottom Cover 2xAAA Split (copy of the bottom cover; original kept): old
    holder rails and switch slot removed, integrated 2-cell compartment (10.2
    channels, 1.2 x 7 divider, 46.7 clear, 0.7 clip slots, 5 mm contact
    openings, wire notches), door opening with latch/tongue pockets; lowered
    3.9 mm so the compartment back wall sits on U1 (remote 21.8 thick)
    - Battery Door 2xAAA: 1.6 flush door, 45 deg far tongues, flexible latch
    finger with hook (press, slide 1.1, lift)
    - Remote Assembly v3: v2 with the split cover + door, holder removed
    - Top cover: user's latest edits and STEP exports
    - Clip and old-holder r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
    [Battery Door 2xAAA.SLDPRT, Bottom Cover 2xAAA Split.SLDPRT, Remote Assembly v3.SLDASM, Top Cover Flex Buttons.SLDPRT, Top Cover Flex Buttons.STEP, Top Cover Flex Buttons.stp]
2026-11-07 Remote v3: PCB-side clips, screwed hook door, PCB corner guides, 30 deg joint
    - Screws now from the front: top cover lugs stop at the ledge (y 4.5),
    Ø2.4 free hole, Ø4.4 x 2 counterbore + 90 deg seat (head 1 mm below the
    face, 2.5 mm free hole); bottom cover back face closed
    - Bottom cover (split): 4 PCB corner guides R3.663 (0.1 mm to the PCB
    notches) up to y 4.5, M2 bores Ø2.0 (11 deep in the guides)
    - Clips go in from the PCB side: slots 1.0 thick (series 21.9 wide),
    stops at the door end (contacts on the cell axis), U contact openings
    toward the PCB, spring openings/windows 6.5 for the Ø6 springs, solder
    access windows and 2x2 solder-leg notches for the + / - clips
    - Comp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
    [Battery Door 2xAAA.SLDPRT, Bottom Cover 2xAAA Split.SLDPRT, Remote Assembly v3.SLDASM, Top Cover Flex Buttons.SLDPRT]
2026-11-07 Cover joint: printable 30 deg bevel with 0.4 mm flats
    For the 0.4 nozzle / 0.2 layer printer the knife edges of the 30 deg joint
    are replaced by flats: 0.4 flat at the outer parting line (y 9.5), 30 deg
    slope from x 0.4 to 1.2, 0.4 flat lip top at y 9.04 (lip 0.46 high).
    Bottom (split) lip and top-cover wall bevel rebuilt to match; covers
    checked for zero overlap in Remote Assembly v3.
    [Bottom Cover 2xAAA Split.SLDPRT, Remote Assembly v3.SLDASM, Top Cover Flex Buttons.SLDPRT]
2026-11-07 Screw mating plane: 0.4 mm gap so the screws clamp the 30 deg bevel
    Bottom-cover PCB guides end 0.4 mm short of the top-cover lugs (guide top at
    assembly y 4.9, lugs stay at the ledge, y 4.5); the guides still cover
    1.2 of the 1.6 mm PCB thickness. Tightening the M2 screws now loads the
    bevel joint instead of the lug faces.
    [Bottom Cover 2xAAA Split.SLDPRT, Remote Assembly v3.SLDASM]
2026-11-07 PCB guides 0.1 mm clear of the top cover walls (print seam)
    The four bottom-cover corner guides were trimmed exactly to the top cover's
    inner wall faces; trimmed again to the 1.6 inset (0.1 mm clearance) from the
    bevel lip top upward so the top cover slides over them despite print seams.
    [Bottom Cover 2xAAA Split.SLDPRT, Remote Assembly v3.SLDASM]
2026-11-07 Door and its cutout: rounded vertical corners (print rule)
    Door body + screw tab corners R1, tab root R1; cover cutout corners R1.15 and
    tab-recess junctions R0.85, concentric with the door so the 0.15 mm gap stays
    even. Door fit re-checked closed and tilted (0 overlap).
    [Battery Door 2xAAA.SLDPRT, Bottom Cover 2xAAA Split.SLDPRT, Remote Assembly v3.SLDASM]
2026-11-07 Battery door: rounded screw ear (R5 at the 2 root corners, R3.5 tip) + recess
    The notchy rectangular screw tab is now an ear blended into the long edge with
    R5 at its two root corners and a R3.5 tip centred on the screw. The cover
    recess follows it 0.15 mm outside (R4.85 / R3.65, concentric); the inside cap
    over the recess is enlarged to keep the lug covered. Door fit checked closed
    and tilted.
    [Battery Door 2xAAA.SLDPRT, Bottom Cover 2xAAA Split.SLDPRT, Remote Assembly v3.SLDASM]
2026-11-07 Door screw lug and its base: R1 on the vertical edges
    Cap corners, cap-to-wall and lug-to-wall junctions of the door-screw lug get R1
    (print rule: rounded build-direction edges).
    [Bottom Cover 2xAAA Split.SLDPRT, Remote Assembly v3.SLDASM]
2026-11-07 Door hook pocket floor 0.7 mm: 0.1 mm Z clearance under the hook flange
    The door's 0.8 mm hook flange (y 0.8-1.6) sat on the pocket floor with no Z
    clearance; the floor now sits 0.7 mm above the printer plate plane.
    [Bottom Cover 2xAAA Split.SLDPRT, Remote Assembly v3.SLDASM]
2026-11-07 Lug base cap runs wall to wall: no sliver gap at the alignment tab
    The door-lug cap stopped 0.02 mm short of the side-wall alignment tab (an
    unprintable sliver that blocks fillets). It now spans from the cover wall to
    the compartment wall, merged with the tab; corners and lug junctions R1.
    [Bottom Cover 2xAAA Split.SLDPRT, Remote Assembly v3.SLDASM]
2026-11-07 Bottom cover: fillet rules applied to the clip/spring cutouts
    Outer vertical edges rounded; inner corners where clips, springs, cells or the
    door flange go left sharp. Contact-wall ends at the U openings get a full round
    (R0.5 on the 1.0 wall, carried round the U bottoms), the 0.8 end wall at the
    solder-leg notches R0.4 both sides, hook pocket mouth R0.4. 0.05 mm slivers in
    the solder windows filled.
    [Bottom Cover 2xAAA Split.SLDPRT, Remote Assembly v3.SLDASM]
2026-11-07 Door: 0.1 mm Z clearance under the support-printed ceilings
    The cover faces that sit on the door's inner face print over support (rough by
    ~0.1 mm): the two door-end strips (user's Sketch9) and the ear mounting plate
    (cap / lug / wall underside over the ear recess) are cut 0.1 mm up.
    [Bottom Cover 2xAAA Split.SLDPRT, Remote Assembly v3.SLDASM]
2026-11-07 Battery clips modelled and placed in Remote Assembly v3
    Simplified series clip (21.6 plate, spring + dimple), + plate (dimple) and
    - spring clip, 0.5 plates on their slot stops against the end walls, springs
    as hollow cones compressed to 4.3, dimples 0.9; solder tabs on the single clips.
    No interference with the cover or PCB.
    [Clip Minus 10 (spring).SLDPRT, Clip Plus 10 (dimple).SLDPRT, Clip Series 21.6 (spring + dimple).SLDPRT, Remote Assembly v3.SLDASM]
2026-11-07 Door hook flange root R0.3 + matching lip chamfer (FEA finding)
    FreeCAD/CalculiX showed ~40-60 MPa along the sharp hook-flange root in a 115 N
    drop case. R0.3 fillet in the root corner; the cover lip's top edge gets a 0.15
    chamfer so the clearance stays >= 0.1 mm. Door fit re-checked.
    [Battery Door 2xAAA.SLDPRT, Bottom Cover 2xAAA Split.SLDPRT, Remote Assembly v3.SLDASM]
2026-11-07 Door: phone number on the inner face for colour printing + print STEPs
    9924343891 in a rounded stroke font, 7.0 high: stroke 0.8 (2 lines of the 0.4 nozzle),
    background between strokes >= 0.8 after the slits, 0.1 x 0.4 deep slit around every
    stroke for the Bambu Studio fill tool, on the door's inner face (print-plate side).
    Cut volumes checked against slit area x 0.4.
    Print STEPs (AP214): top cover (8 bodies), split bottom cover, door.
    [Battery Door 2xAAA.SLDPRT, Battery Door 2xAAA.stp, Bottom Cover 2xAAA Split.stp, Top Cover Flex Buttons.STEP, Top Cover Flex Buttons.stp]
2026-11-07 Door text: 9924343891 + TIMER REMOTE, 0.84 stroke (2 x 0.42 lines)
    Two lines on the door's inner face (print-plate side): number 7.0 high, TIMER REMOTE
    5.0 high. Stroke 0.84 = 2 lines of the 0.42 line width, background >= 0.84 after the
    0.1 x 0.4 deep colour slits (gaps 1.04). Square M, flat-flag 1, wide R so no
    background sliver is thinner than 2 lines. Cut volumes checked.
    [Battery Door 2xAAA.SLDPRT, Battery Door 2xAAA.stp]
2026-11-07 Refresh print STEPs (top cover, split bottom cover, door with text)
    [Battery Door 2xAAA.stp, Bottom Cover 2xAAA Split.stp, Top Cover Flex Buttons.STEP, Top Cover Flex Buttons.stp]
2026-11-08 Trial-print fixes: clips flipped/swapped, divider 0.8, wider channels, 3x3 notches, OLED +0.3
    User feedback after the first print:
    - series clip barb stamped the other way -> series clip flipped, + (dimple) and - (spring)
    clips swapped: spring openings 6.5 + back-wall windows moved to the other cell at
    both ends (sketch shifts of +/-11.4, positions asserted); clips re-placed in v3.
    - cells too tight: divider 1.2 -> 0.8 (x19.6-20.4), side walls pushed out 0.1 above the
    door level (x9.1 / 30.9): channels 10.5 for the 10.1 cells (-222.995 mm3, = FreeCAD).
    - solder-leg notches 2x2 -> 3x3 (-8.000 mm3); U-end R0.5 and notch-end R0.39 rounds rebuilt.
    - top cover: OLED window +0.3 on the I2C-h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
    [Battery Door 2xAAA.stp, Bottom Cover 2xAAA Split.SLDPRT, Bottom Cover 2xAAA Split.stp, Remote Assembly v3.SLDASM, Top Cover Flex Buttons.SLDPRT, Top Cover Flex Buttons.STEP, Top Cover Flex Buttons.stp]
2026-11-08 Top cover: front countersinks 1.0 deeper for 8 mm M2 screws + STEPs
    User has M2x8 CSK screws (not 10): head counterbore O4.4 2.0 -> 3.0 deep, 90 deg seat
    follows (head top 2 mm below the face). Grip in the bottom bosses 5.1 mm, free O2.4
    hole under the seat 1.5 mm (user chose 1.0 deeper over 2.0). -42.726 mm3 as calculated.
    [Top Cover Flex Buttons.SLDPRT, Top Cover Flex Buttons.STEP, Top Cover Flex Buttons.stp]
2026-11-09 CAD: latest Bottom Cover 2xAAA Split and Remote Assembly v2/v3 (SolidWorks saves)
    [Bottom Cover 2xAAA Split.SLDPRT, Remote Assembly v2.SLDASM, Remote Assembly v3.SLDASM]
